RaihanRafi12/Autonomous-Surveillance-and-Navigation-Bot/docs/overleaf/image/README.md

# Paper Figures — `overleaf/image/`

Place the following image files in this directory before compiling `main.tex`:

| Filename | Used in Paper | Description |
|---|---|---|
| `pipeline_flow.png` | Fig. 1 | System processing pipeline / block diagram |
| `rover_hardware.png` | Fig. 2 | Annotated 6WD rover hardware layout |
| `rover_front.jpg` | Fig. 3 | Front sensor deck photograph |
| `rover_back.jpg` | Fig. 3 | Rear compute deck photograph |
| `dashboard_ui.png` | Fig. 4 | Web dashboard HUD screenshot |

Legacy filenames from earlier drafts (`image2.png`, `Gemini_Generated_Image_*.png`) can be renamed to match the table above.
