RaihanRafi12/Autonomous-Surveillance-and-Navigation-Bot/docs/overleaf/image/Dashboard_01.PNG

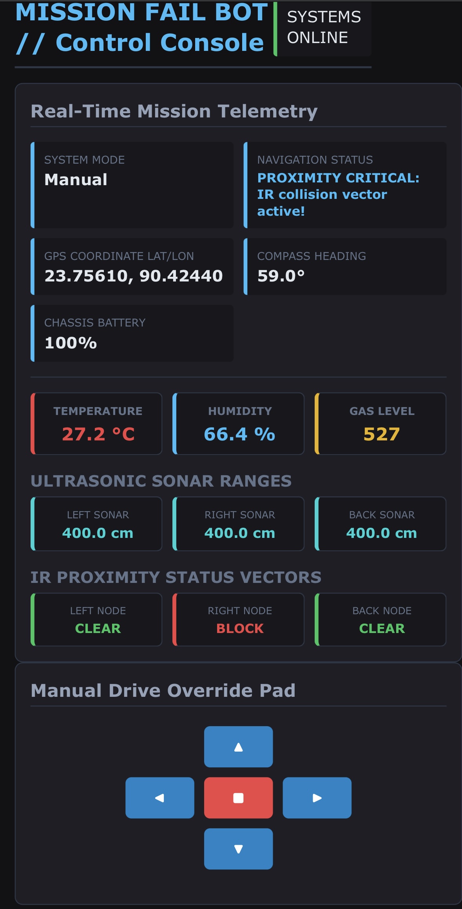
docs/overleaf/image/Dashboard_01.PNG
