RaihanRafi12/Autonomous-Surveillance-and-Navigation-Bot/docs/overleaf/image/Dashboard_02.PNG

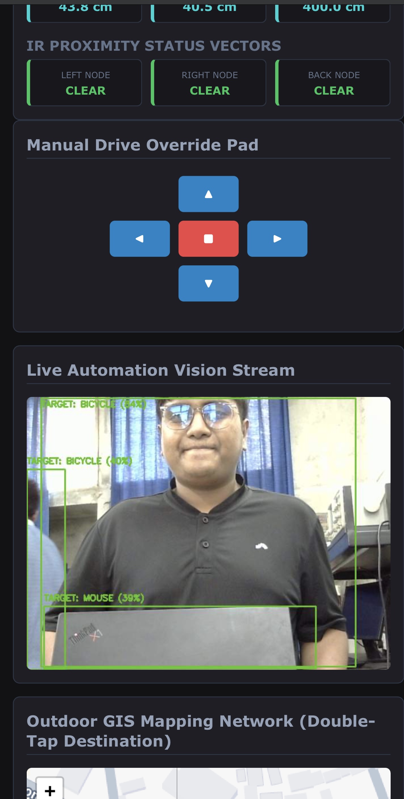
docs/overleaf/image/Dashboard_02.PNG
