RaihanRafi12/Autonomous-Surveillance-and-Navigation-Bot/docs/overleaf/image/Front_View.jpeg

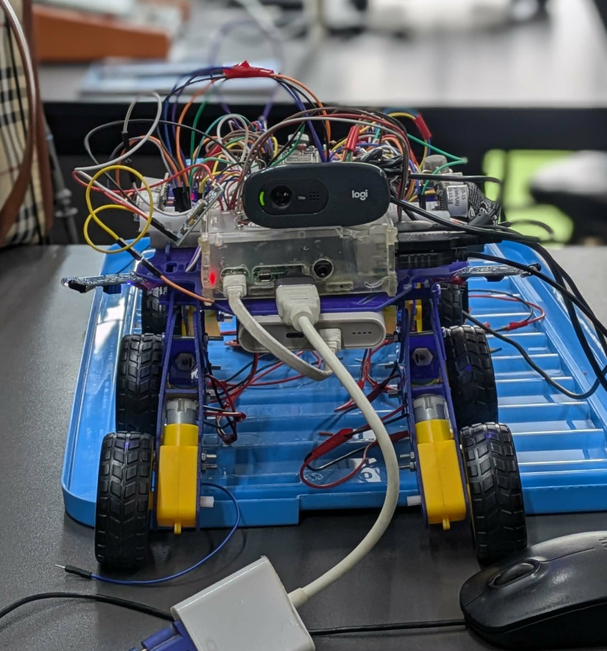
docs/overleaf/image/Front_View.jpeg
