RaihanRafi12/Autonomous-Surveillance-and-Navigation-Bot/static/floorplan.jpg

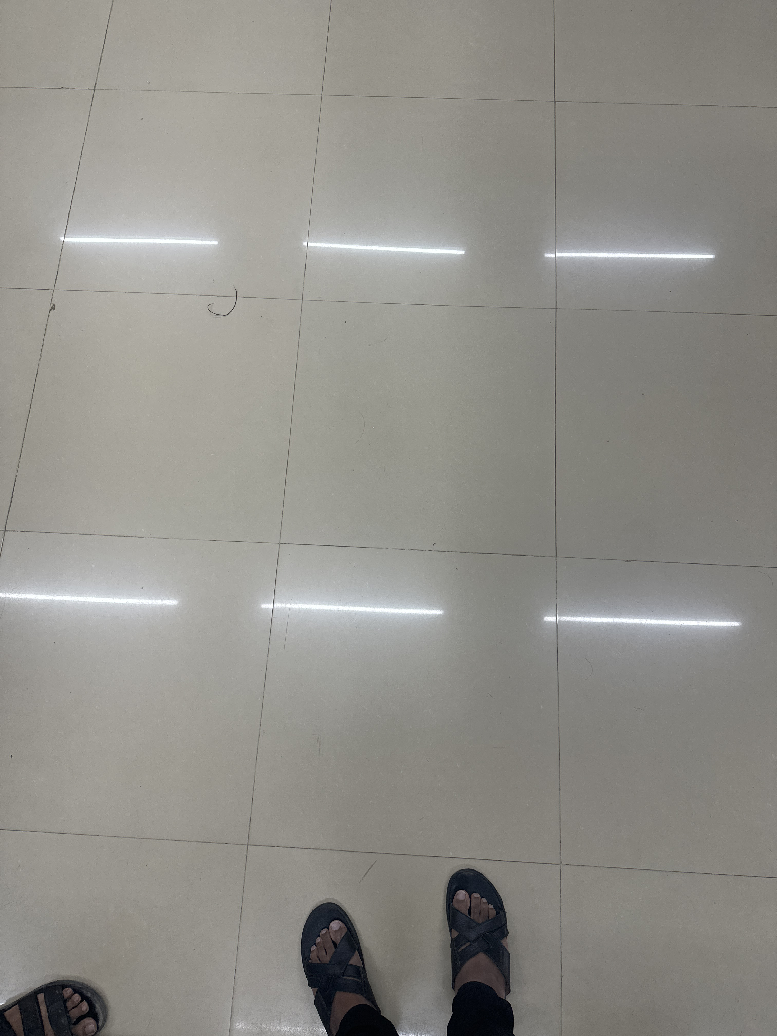
static/floorplan.jpg
