RaihanRafi12/Autonomous-Surveillance-and-Navigation-Bot/(notices)

Notices in the files:
README.md:
License: MIT
